Harry-IV/Float-Boards-24-25/Glass Squid V2/Glass Squid V2.kicad_pcb

## KiCad design Glass Squid V2/Glass Squid V2.kicad_pcb (2025-02-23)

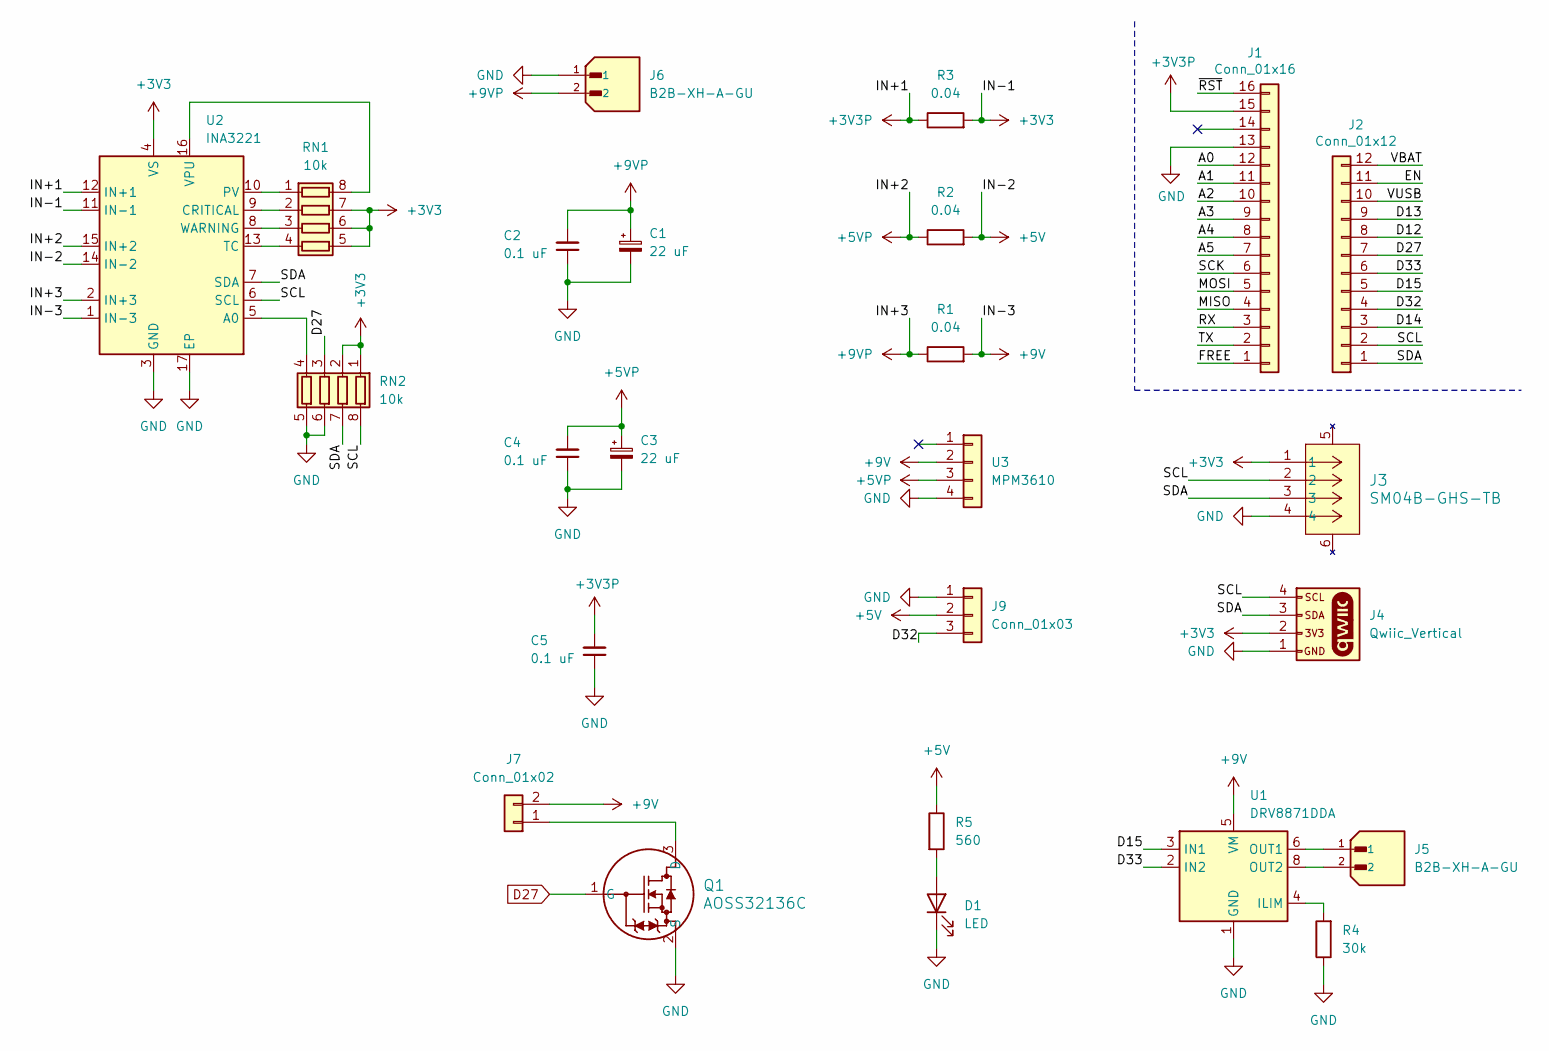
[picture p1: schematic Glass Squid V2.kicad_sch]

Parts:
C1, C3: 22 uF; CAP_ZC_C_PAN; Part # EEH-ZA1J220XP
C2, C4, C5: 0.1 uF; CAPC2012X140N; Part # C0805C104J5RACAUTO
D1: LED; WL-SMCW_0805; Part # 150080RS75000
J1: Conn_01x16; PinHeader_1x16_P2.54mm_Vertical; Part # N/A
J2: Conn_01x12; PinHeader_1x12_P2.54mm_Vertical; Part # N/A
J3: SM04B-GHS-TB; CONN_SM04B-GHS-TB_JST; Part # SM04B-GHS-TB
J4: Qwiic_Vertical; JST_SMD_1.0mm-4_Vertical; Part # BM04B-SRSS-TB
J5, J6: B2B-XH-A-GU; B2B-XH-A; Part # B2B-XH-A-GU
J7: Conn_01x02; PinHeader_1x02_P2.54mm_Vertical; Part # 215297-2
J9: Conn_01x03; PinHeader_1x03_P2.54mm_Vertical; Part # 61300311121
Q1: AOSS32136C; SOT23_AOS; Part # AOSS32136C
R1, R2, R3: 0.04; RES_VISHAY_WSLP0805_VIS; Part # WSLP0805R0400DEA
R4: 30k; RESC2012X60N; Part # SG73S2ATTD3002F
R5: 560; RES_CHP0805_BRN; Part # CHP0805AFX-5600ELF
RN1, RN2: 10k; EXB38V_PAN; Part # EXB-38V103JV
U1: DRV8871DDA; Texas_HTSOP-8-1EP_3.9x4.9mm_P1.27mm_EP2.95x4.9mm_Mask2.4x3.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; Part # DRV8871DDARQ1
U2: INA3221; Texas_RGV0016A_VQFN-16-1EP_4x4mm_P0.65mm_EP2.1x2.1mm; Part # INA3221AQRGVRQ1
U3: MPM3610; PinHeader_1x04_P2.54mm_Vertical; Part # 4739

Connections:
+3V3: J3.1, J4.2, R3.2, RN1.5 (R4.2), RN1.6 (R3.2), RN1.7 (R2.2), RN2.1 (R1.1), RN2.2 (R2.1), U2.4 (VS), U2.11 (IN-1)
+3V3P: C5.2, J1.15, R3.1, U2.12 (IN+1)
+5V: J9.2, R2.2, R5.1, U2.14 (IN-2)
+5VP: C3.1, C4.2, R2.1, U2.15 (IN+2), U3.3
+9V: J7.2, R1.2, U1.5 (VM), U2.1 (IN-3), U3.2
+9VP: C1.1, C2.2, J6.2, R1.1, U2.2 (IN+3)
/A0: J1.12
/A1: J1.11
/A2: J1.10
/A3: J1.9
/A4: J1.8
/A5: J1.7
/D12: J2.8
/D13: J2.9
/D14: J2.3
/D15: J2.5, U1.3 (IN1)
/D32: J2.4, J9.3
/D33: J2.6, U1.2 (IN2)
/EN: J2.11
/FREE: J1.1
/MISO: J1.4
/MOSI: J1.5
/RX: J1.3
/SCK: J1.6
/SCL: J2.2, J3.2, J4.4, RN2.8 (R1.2), U2.6 (SCL)
/SDA: J2.1, J3.3, J4.3, RN2.7 (R2.2), U2.7 (SDA)
/TX: J1.2
/VBAT: J2.12
/VUSB: J2.10
/~RST: J1.16
D27: J2.7, Q1.1 (G), RN2.3 (R3.1)
GND: C1.2, C2.1, C3.2, C4.1, C5.1, D1.1 (K), J1.13, J3.4, J4.1, J6.1, J9.1, Q1.2 (S), R4.1, RN2.5 (R4.2), RN2.6 (R3.2), U1.1 (GND), U1.7 (GND), U1.9 (GND), U2.3 (GND), U2.17 (EP), U3.4
unnamed: D1.2 (A), R5.2
unnamed: J7.1, Q1.3 (D)
unnamed: RN1.1 (R1.1), U2.10 (PV)
unnamed: RN1.8 (R1.2), U2.16 (VPU)
unnamed: RN1.2 (R2.1), U2.9 (CRITICAL)
unnamed: RN1.3 (R3.1), U2.8 (WARNING)
unnamed: RN1.4 (R4.1), U2.13 (TC)
unnamed: RN2.4 (R4.1), U2.5 (A0)
unnamed: R4.2, U1.4 (ILIM)
unnamed: J5.1, U1.6 (OUT1)
unnamed: J5.2, U1.8 (OUT2)

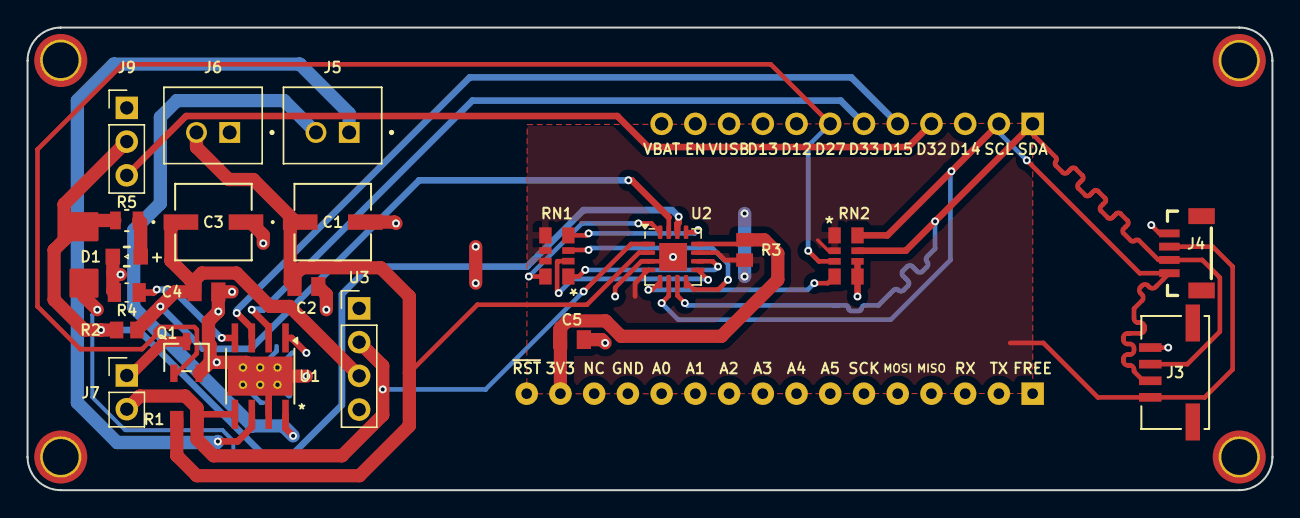
[picture p2: board Glass Squid V2.kicad_pcb from above]

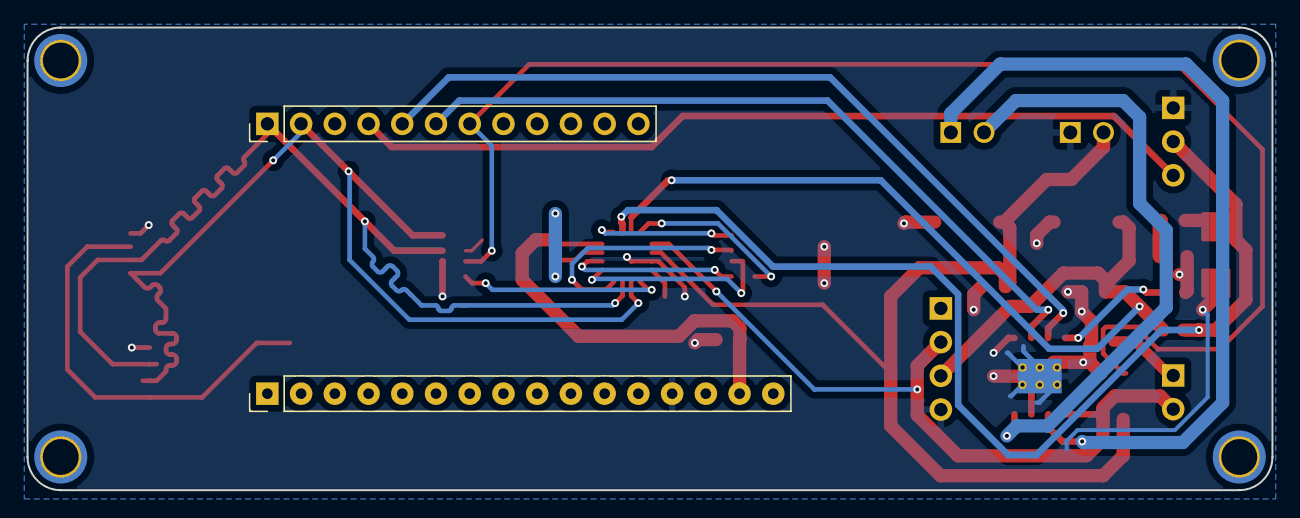
[picture p3: board Glass Squid V2.kicad_pcb from below]

Board: 2 copper layers, 93.8 x 34.8 mm, 25 parts (2 on the bottom side), 24 nets.
