Harry-IV/Float-Boards-24-25/Float Power Board V1/Float Power Board V1.kicad_pcb

## KiCad design Float Power Board V1/Float Power Board V1.kicad_pcb (2025-02-23)

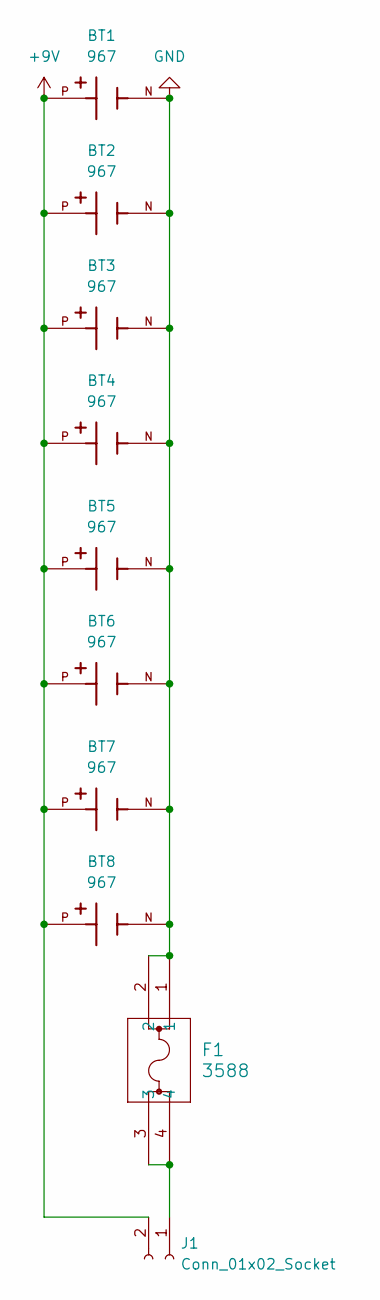
[picture p4: schematic Float Power Board V1.kicad_sch]

Parts:
BT1, BT2, BT3, BT4, BT5, BT7, BT8: 967; 9V Battery Holder; Part # 967
BT6: 967; 9V Battery Holder
F1: 3588; 3588_KEY; Part # 3588
J1: Conn_01x02_Socket; AMASS_XT30U-M_1x02_P5.0mm_Vertical

Connections:
+9V: BT1.P, BT2.P, BT3.P, BT4.P, BT5.P, BT6.P, BT7.P, BT8.P, J1.2
GND: BT1.N, BT2.N, BT3.N, BT4.N, BT5.N, BT6.N, BT7.N, BT8.N, F1.1, F1.2
unnamed: F1.3, F1.4, J1.1

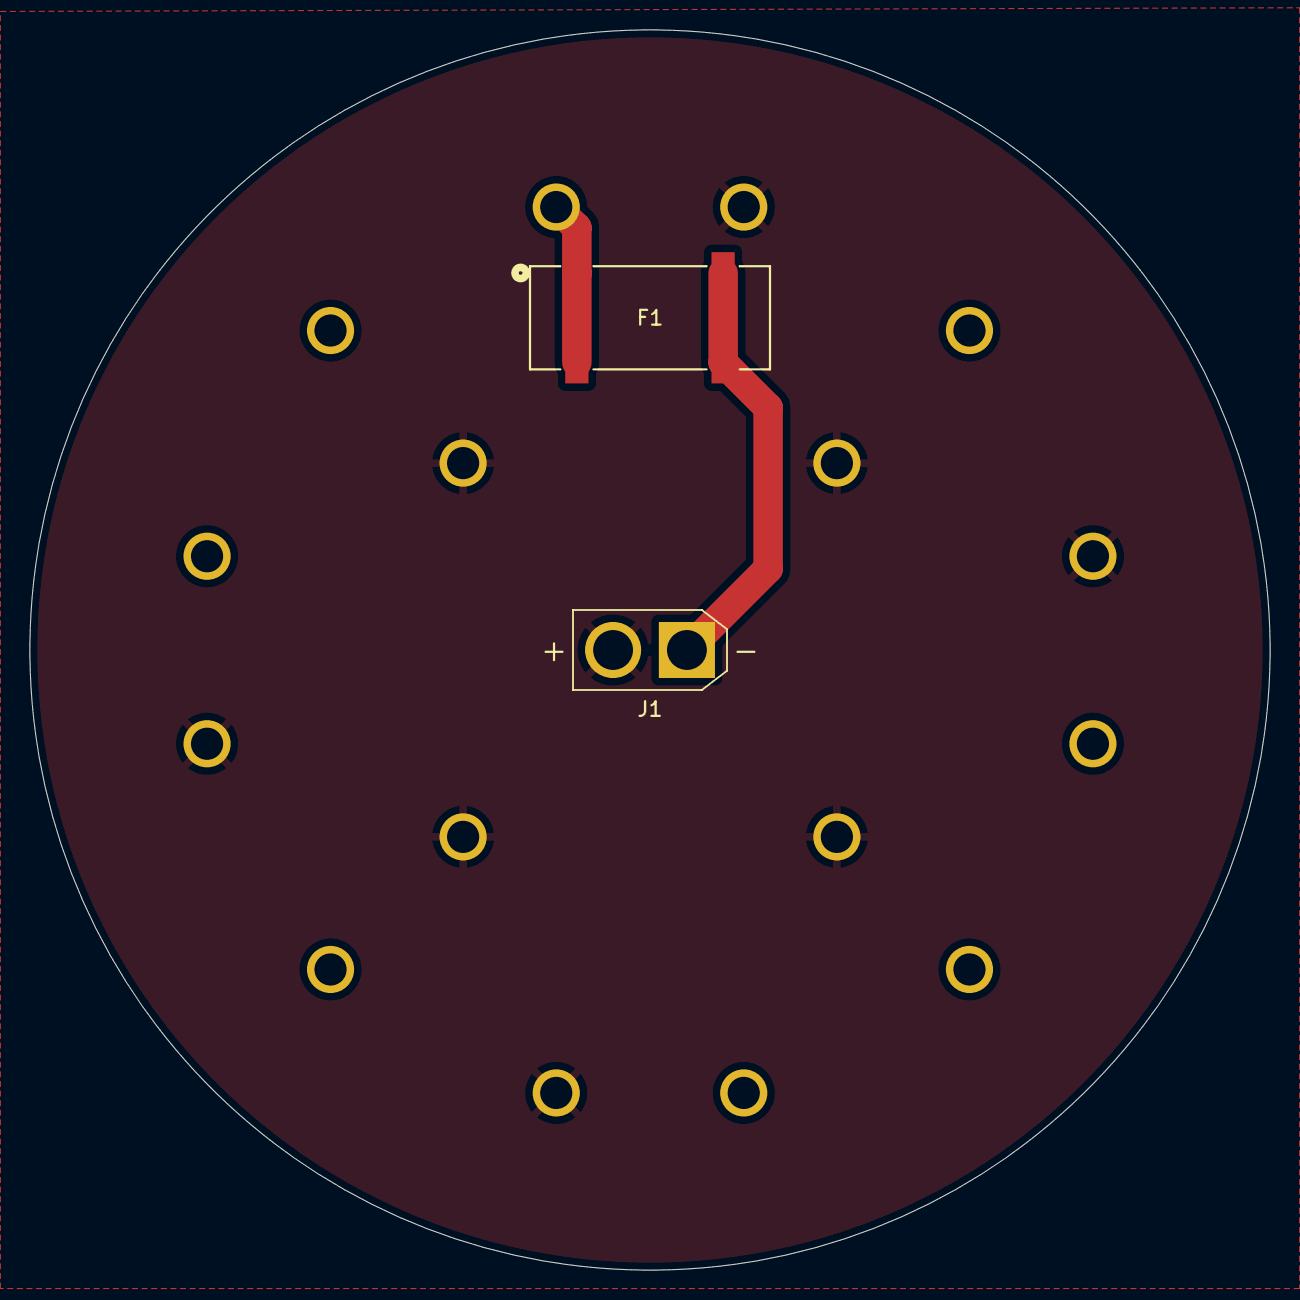
[picture p5: board Float Power Board V1.kicad_pcb from above]

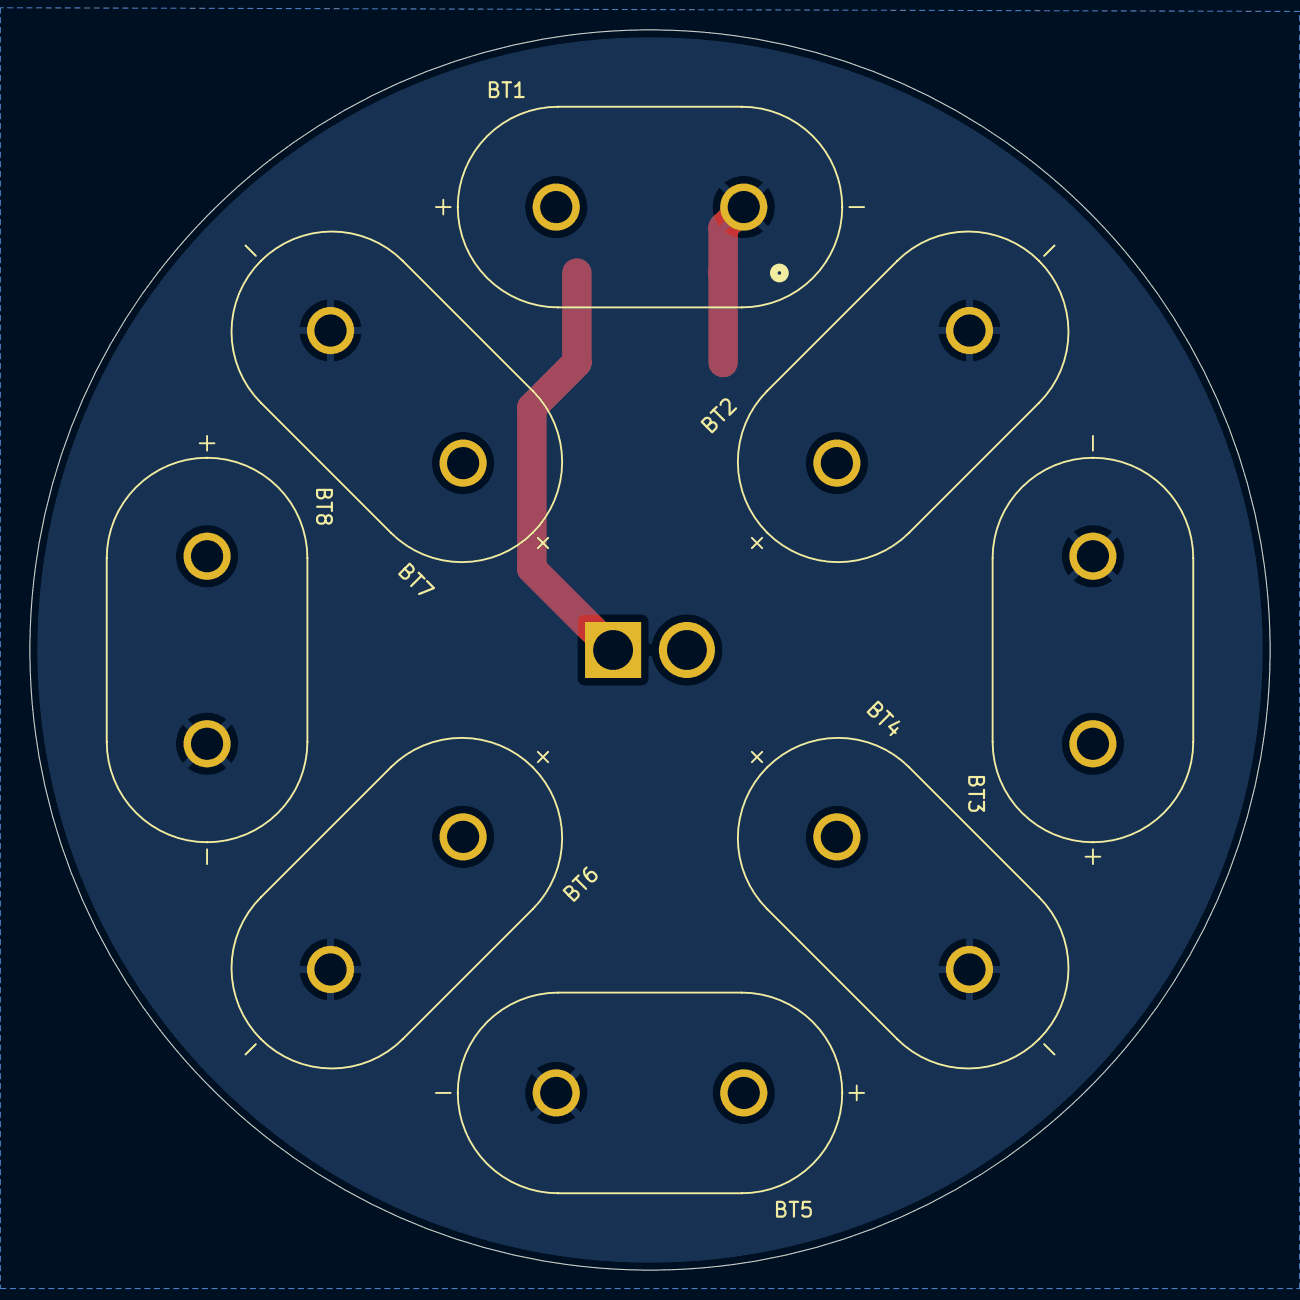
[picture p6: board Float Power Board V1.kicad_pcb from below]

Board: 2 copper layers, 84.0 x 84.0 mm, 10 parts (8 on the bottom side), 3 nets.
