Harry-IV/Float-Boards-24-25/(commit log)

2025-02-15 Initial commit of boards. Not ordered yet.
    [Float Power Board V1.kicad_pcb, Float Power Board V1.kicad_sch, Glass Squid V2.kicad_pcb, Glass Squid V2.kicad_sch, Pad - Top V1.kicad_pcb, Pad - Top V1.kicad_sch, Pogo - Bottom V1.kicad_pcb, Pogo - Bottom V1.kicad_sch]
2025-02-20 Made top board the pogo board and bulkhead the pad board.
    [Float Power Board V1.kicad_pcb, Pad - Bottom V1.kicad_pcb, Pad - Bottom V1.kicad_sch, Pogo - Top V1.kicad_pcb, Pogo - Top V1.kicad_sch]
2025-02-20 Fixed alingment pin placement and sizing for pogo and pad boards.
    [Pad - Bottom V1.kicad_pcb, Pogo - Top V1.kicad_pcb]
2025-02-20 Precautionary commit
    [Pad - Bottom V1.kicad_pcb, Pad - Bottom V1.kicad_sch, Pogo - Top V1.kicad_sch]
2025-02-20 Finally fixed the issues with folder and file naming.
    [Pad - Bottom V1.kicad_pcb, Pad - Bottom V1.kicad_sch, Pogo - Top V1.kicad_pcb, Pogo - Top V1.kicad_sch]
2025-02-20 Created interactive BOMs for Pogo and pad boards.
    [Pogo - Top V1.kicad_pcb, Pogo - Top V1.kicad_sch]
2025-02-23 V1 of Float Boards ... most likely :)
    [Float Power Board V1.kicad_pcb, Float Power Board V1.kicad_sch, Glass Squid V2.kicad_pcb, Glass Squid V2.kicad_sch]
2025-02-23 Created .zip files and ordered the boards.
    [Float Power Board V1.kicad_pcb, Glass Squid V2.kicad_pcb, Pad - Bottom V1.kicad_pcb, Pogo - Top V1.kicad_pcb]
